IncludedGem/Illuminati-on/README.md

# Illuminati-on
HACK 2026 Team 13 Musical Instrument

Run serial.py then serial_bridge.py, open the site, then start the pico.
