IncludedGem/Illuminati-on/cad/fullKey.step

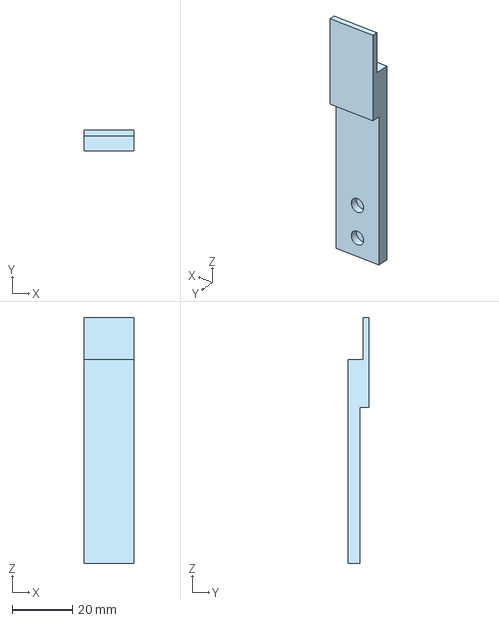
[picture p1: CAD file, 2026-08-09]
cad/fullKey.step
16.5 x 7.00 x 82.0 mm
