IncludedGem/Illuminati-on/cad/arrowButton.step

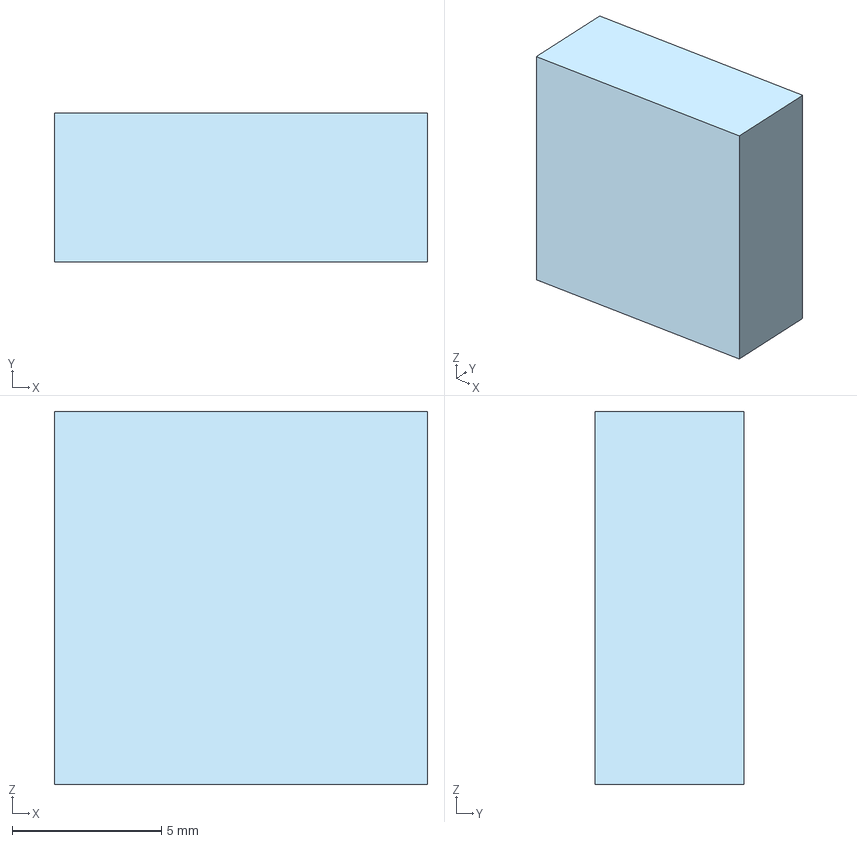
[picture p2: CAD file, 2026-08-11]
cad/arrowButton.step
12.5 x 5.00 x 12.5 mm
