IncludedGem/Illuminati-on/cad/playPauseButton.step

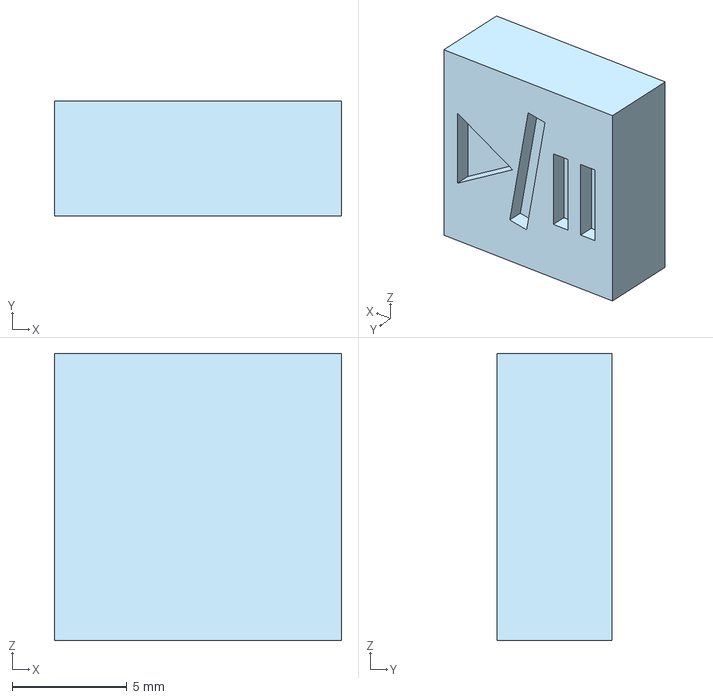
[picture p3: CAD file, 2026-08-11]
cad/playPauseButton.step
12.5 x 5.00 x 12.5 mm
