IncludedGem/Illuminati-on/cad/insideSupport.step

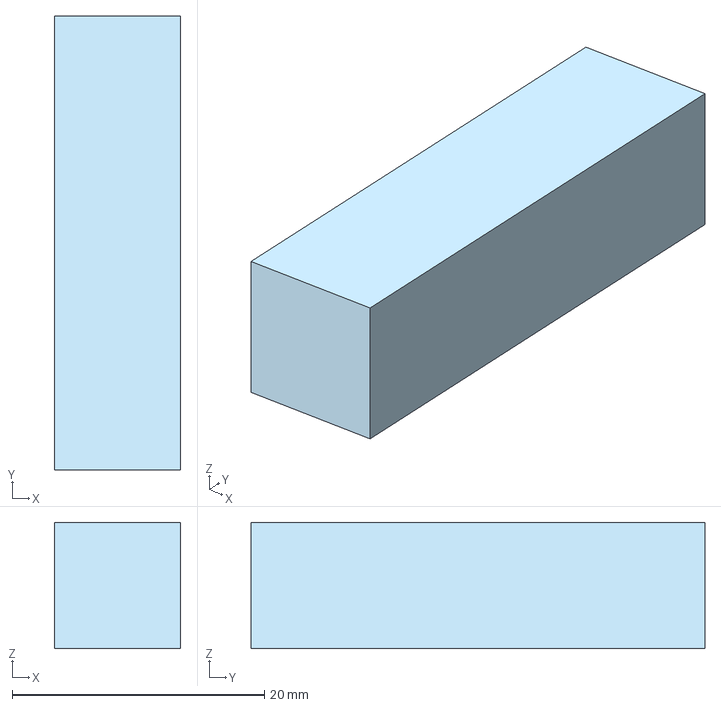
[picture p4: CAD file, 2026-08-11]
cad/insideSupport.step
10.0 x 36.0 x 10.0 mm
