IncludedGem/Illuminati-on/cad/pButton.step

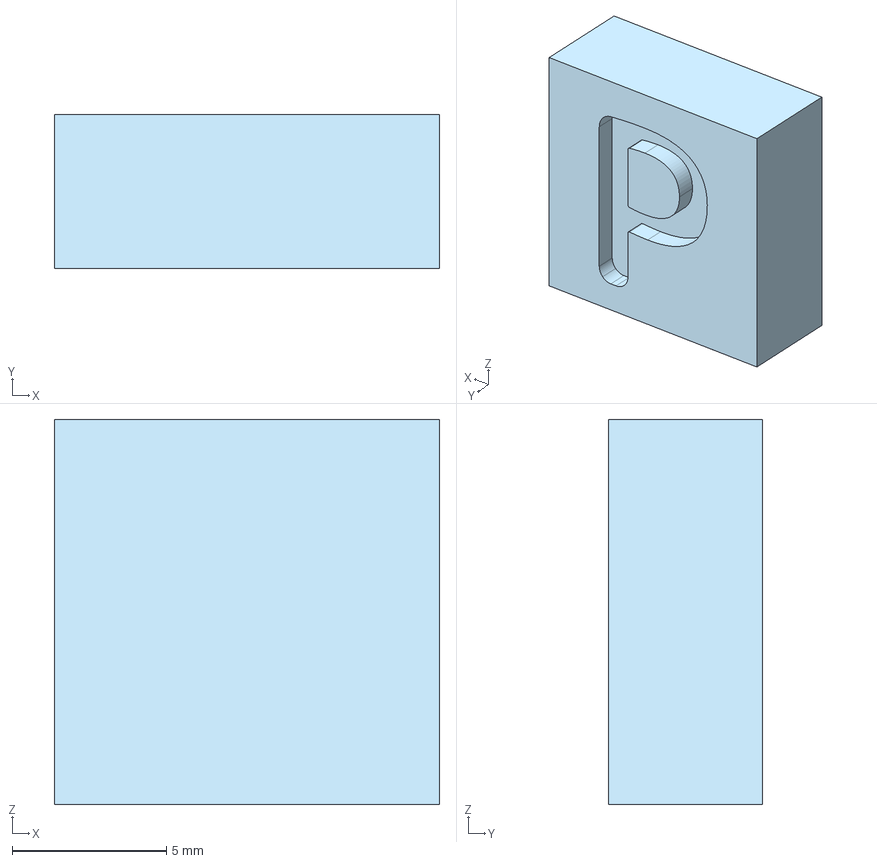
[picture p5: CAD file, 2026-08-11]
cad/pButton.step
12.5 x 5.00 x 12.5 mm
