IncludedGem/Illuminati-on/cad/recordButton.step

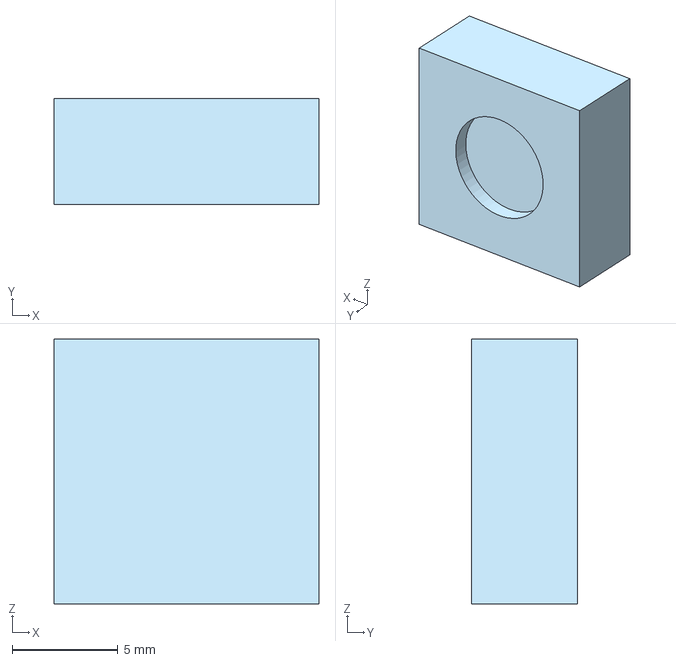
[picture p6: CAD file, 2026-08-11]
cad/recordButton.step
12.5 x 5.00 x 12.5 mm
