IncludedGem/Illuminati-on/cad/blackKey.step

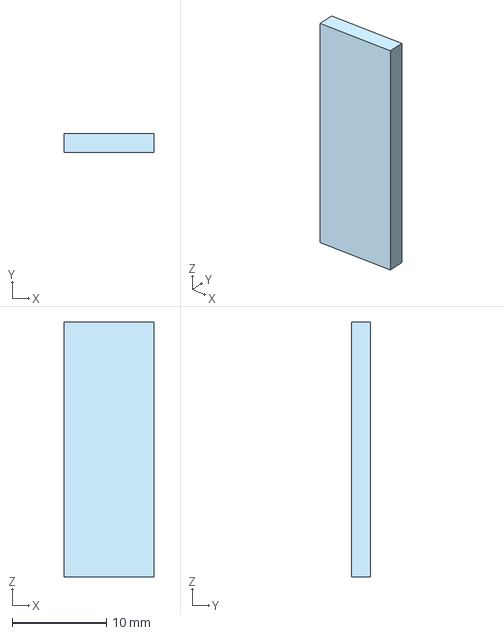
[picture p7: CAD file, 2026-08-11]
cad/blackKey.step
9.50 x 2.00 x 27.0 mm
