IncludedGem/Illuminati-on/cad/plate.dxf

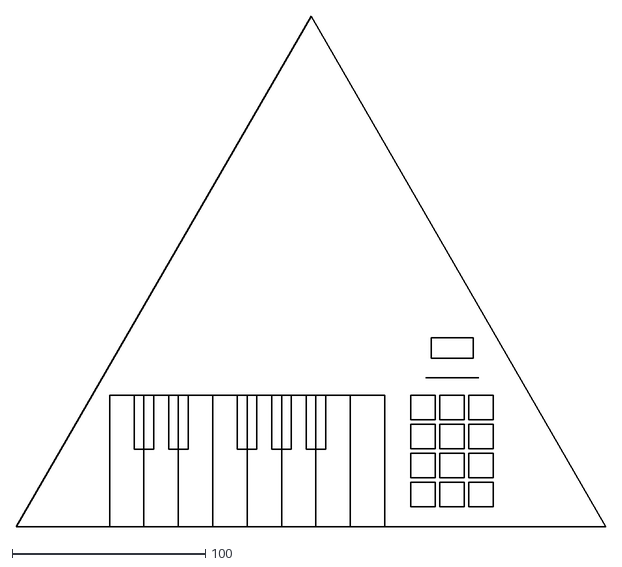
[picture p8: CAD file, 2026-08-09]
cad/plate.dxf
304.8 x 264.0
