IncludedGem/Illuminati-on/cad/2ND PLATE.dxf

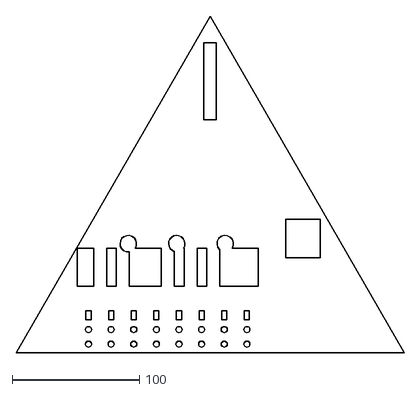
[picture p9: CAD file, 2026-08-09]
cad/2ND PLATE.dxf
304.8 x 264.0
