IncludedGem/Illuminati-on/cad/PLATE3.dxf

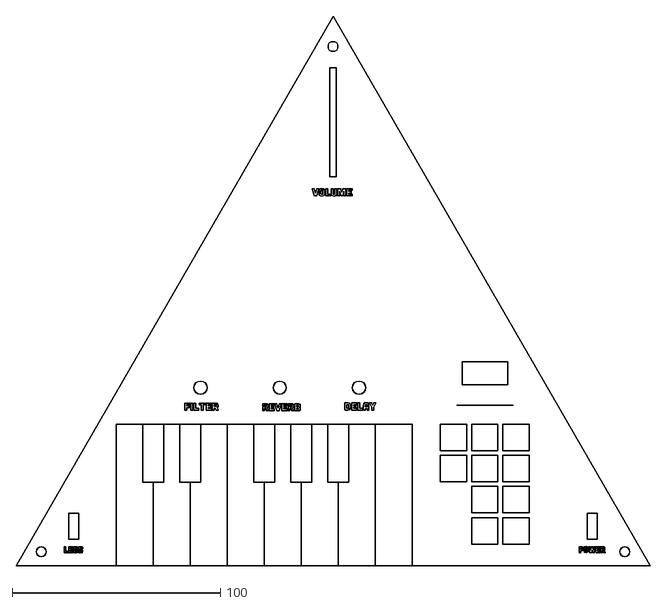
[picture p10: CAD file, 2026-08-09]
cad/PLATE3.dxf
304.8 x 264.0
