IncludedGem/Illuminati-on/cad/plate2.dxf

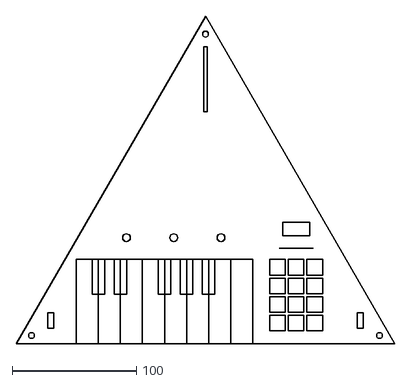
[picture p11: CAD file, 2026-08-09]
cad/plate2.dxf
304.8 x 264.0
