IncludedGem/Illuminati-on/cad/leftKey.step

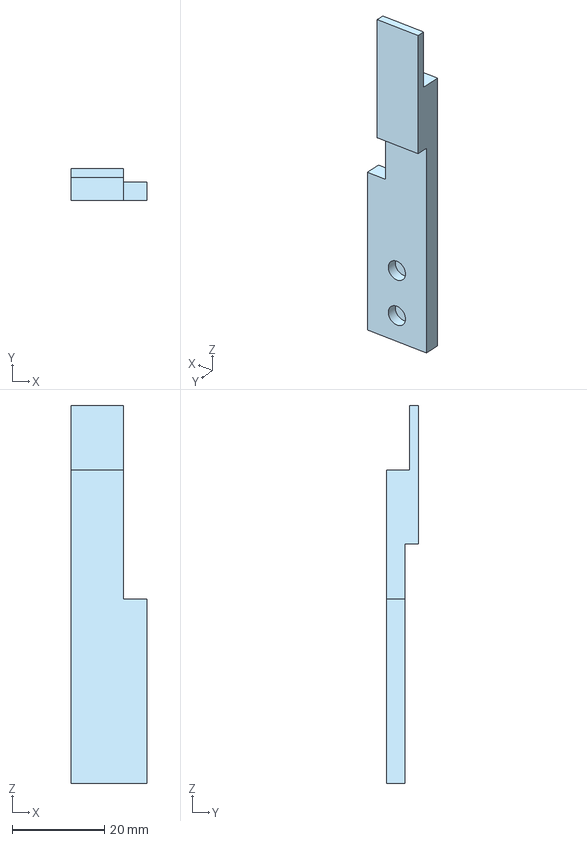
[picture p12: CAD file, 2026-08-09]
cad/leftKey.step
16.5 x 7.00 x 82.0 mm
