IncludedGem/Illuminati-on/cad/centerKey.step

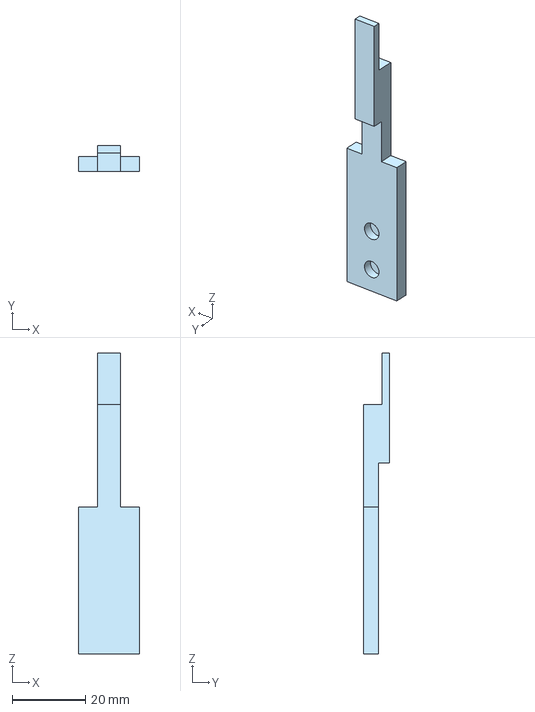
[picture p13: CAD file, 2026-08-09]
cad/centerKey.step
16.5 x 7.00 x 82.0 mm
