IncludedGem/Illuminati-on/cad/logo_triangle.dxf

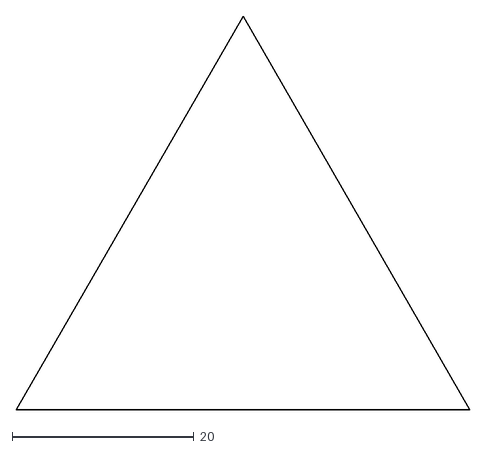
[picture p14: CAD file, 2026-08-09]
cad/logo_triangle.dxf
50.0 x 43.3
