IncludedGem/Illuminati-on/cad/cablePanel13.dxf

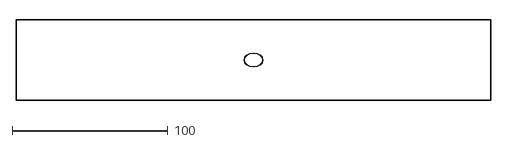
[picture p15: CAD file, 2026-08-09]
cad/cablePanel13.dxf
304.8 x 52.0
