IncludedGem/Illuminati-on/cad/speakerPanel13.dxf

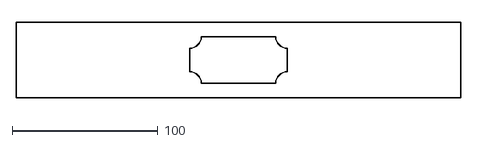
[picture p16: CAD file, 2026-08-09]
cad/speakerPanel13.dxf
304.8 x 52.0
