IncludedGem/Illuminati-on/cad/volumeHandle.step

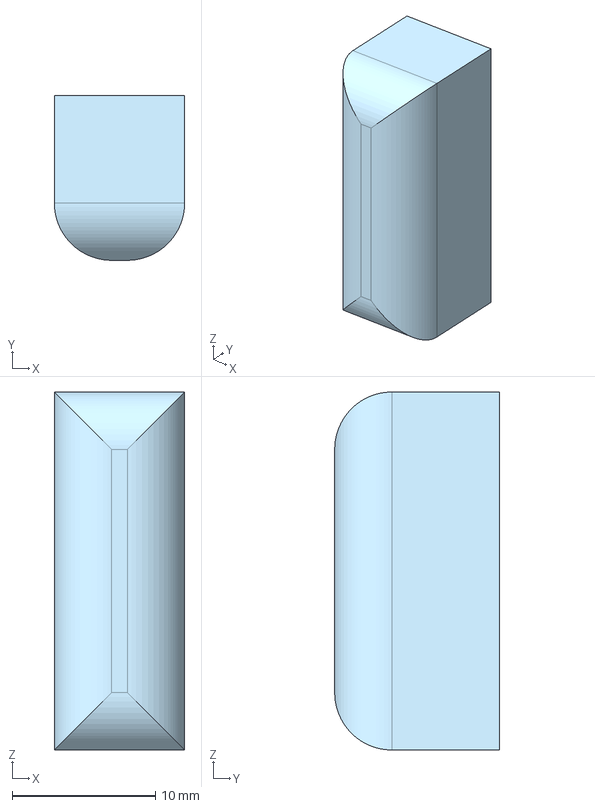
[picture p17: CAD file, 2026-08-09]
cad/volumeHandle.step
9.10 x 11.5 x 25.0 mm
