IncludedGem/Illuminati-on/(list of files, cad)

Other CAD files:
cad/mButton.step
cad/resetButton.step
cad/rightKey.step
