IncludedGem/Illuminati-on/Circuitry/illuminati-on Electronic Schematic - Final.pdf

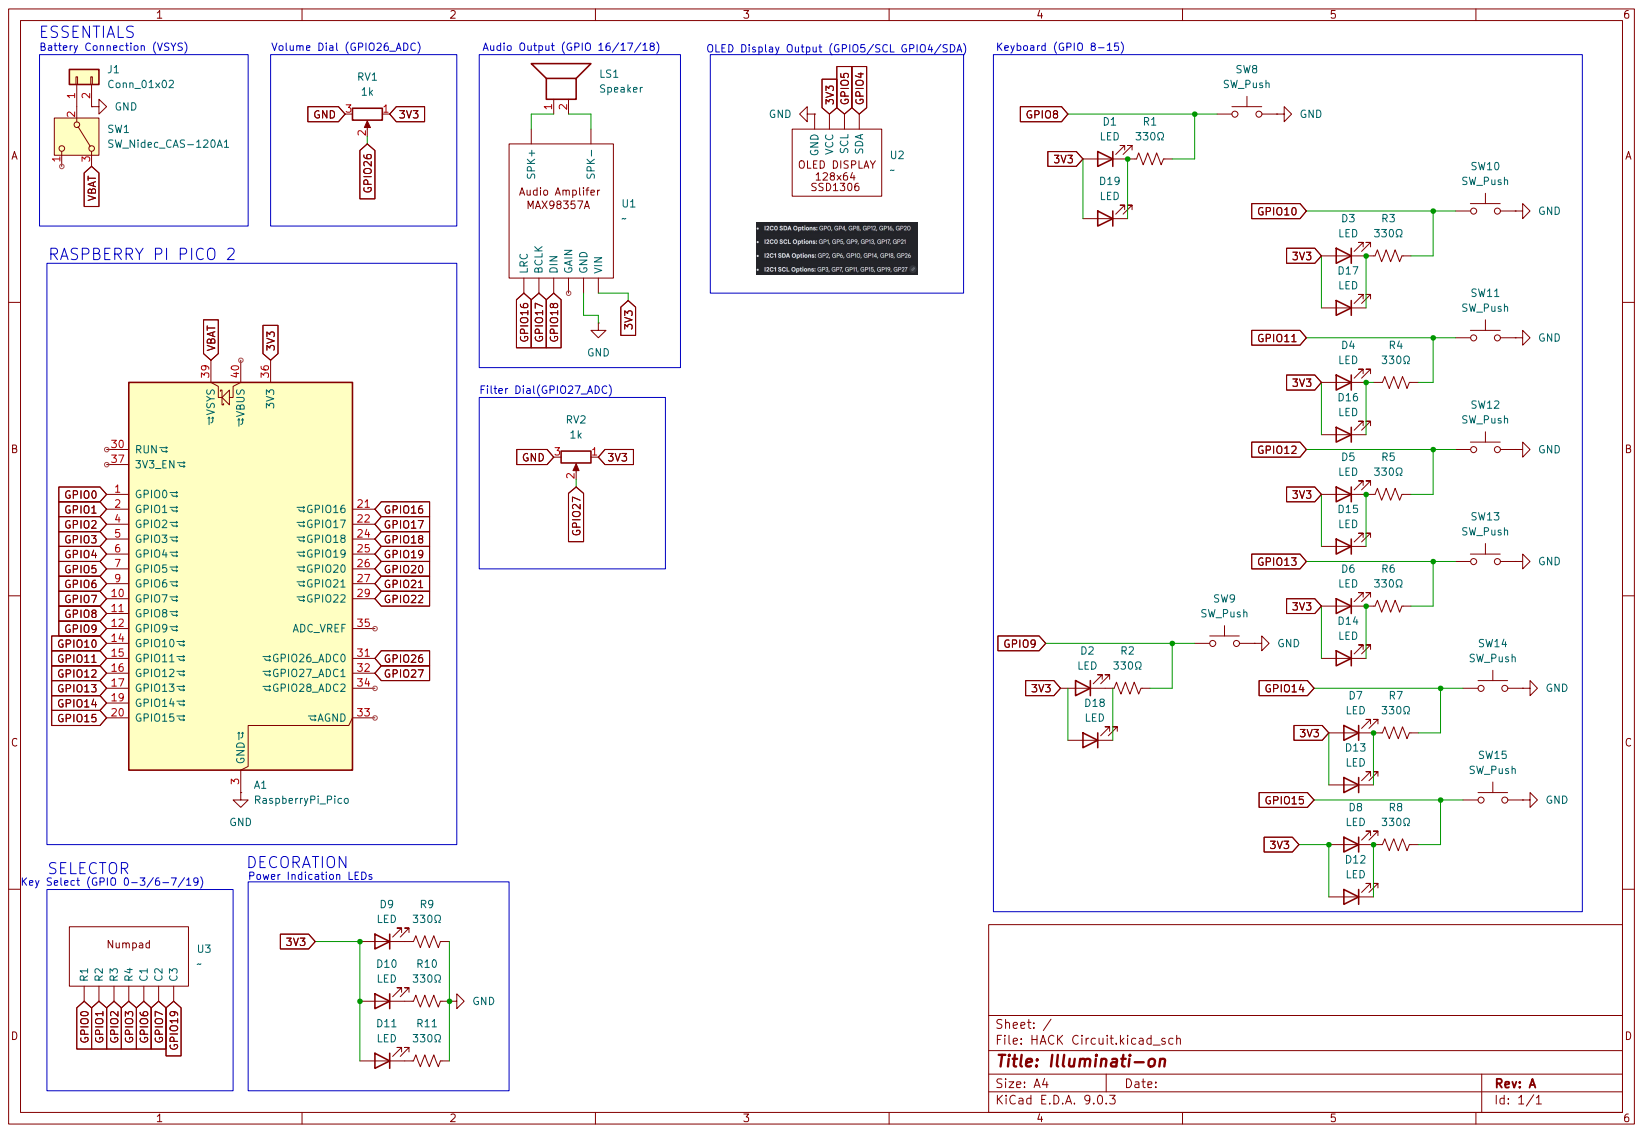
[picture p18: page 1]
