IncludedGem/Illuminati-on/Circuitry/illuminati-on Electronic Schematic - Plan.pdf

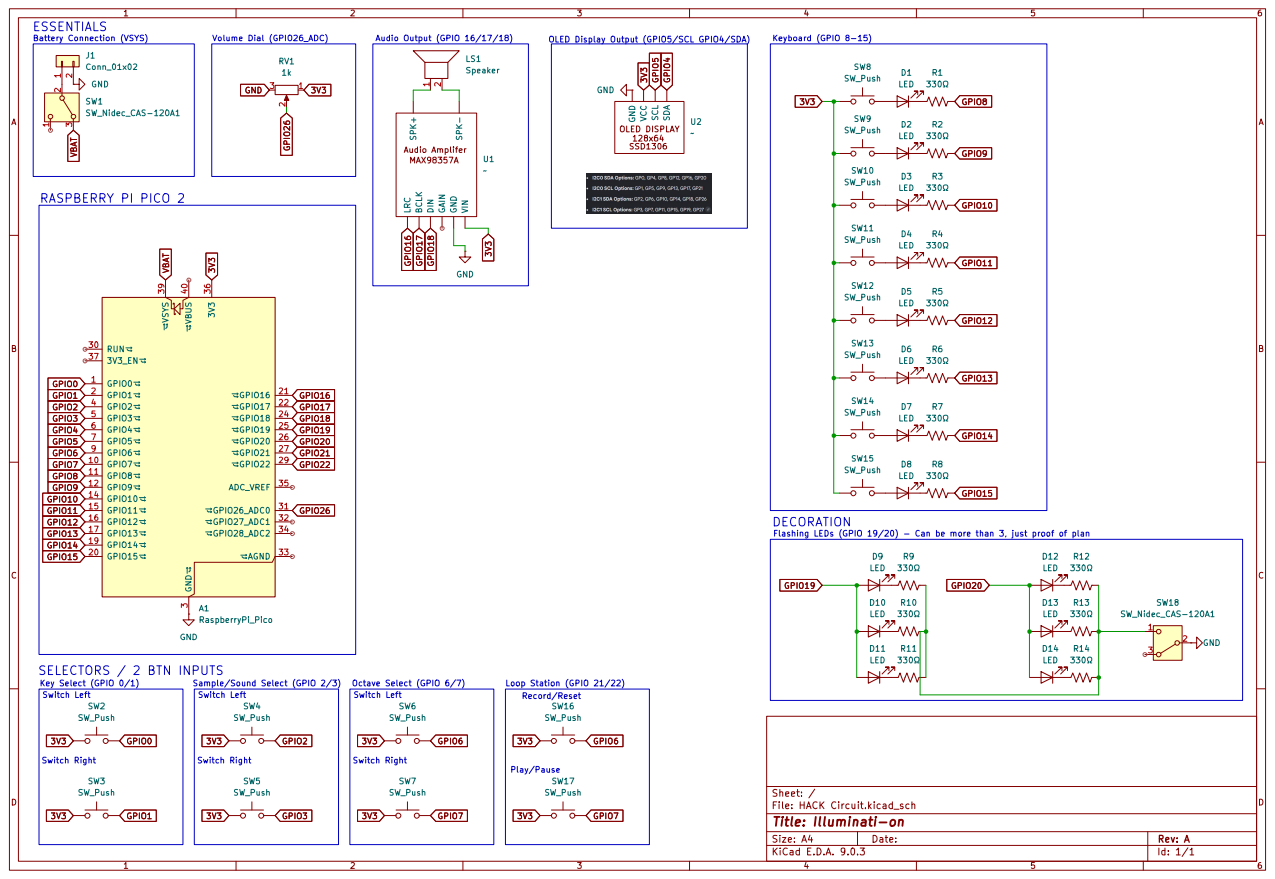
[picture p19: page 1]
