IncludedGem/Illuminati-on/Circuitry/HACK Circuit.kicad_sch

## KiCad design Circuitry/HACK Circuit.kicad_sch (2026-08-11, an earlier design)

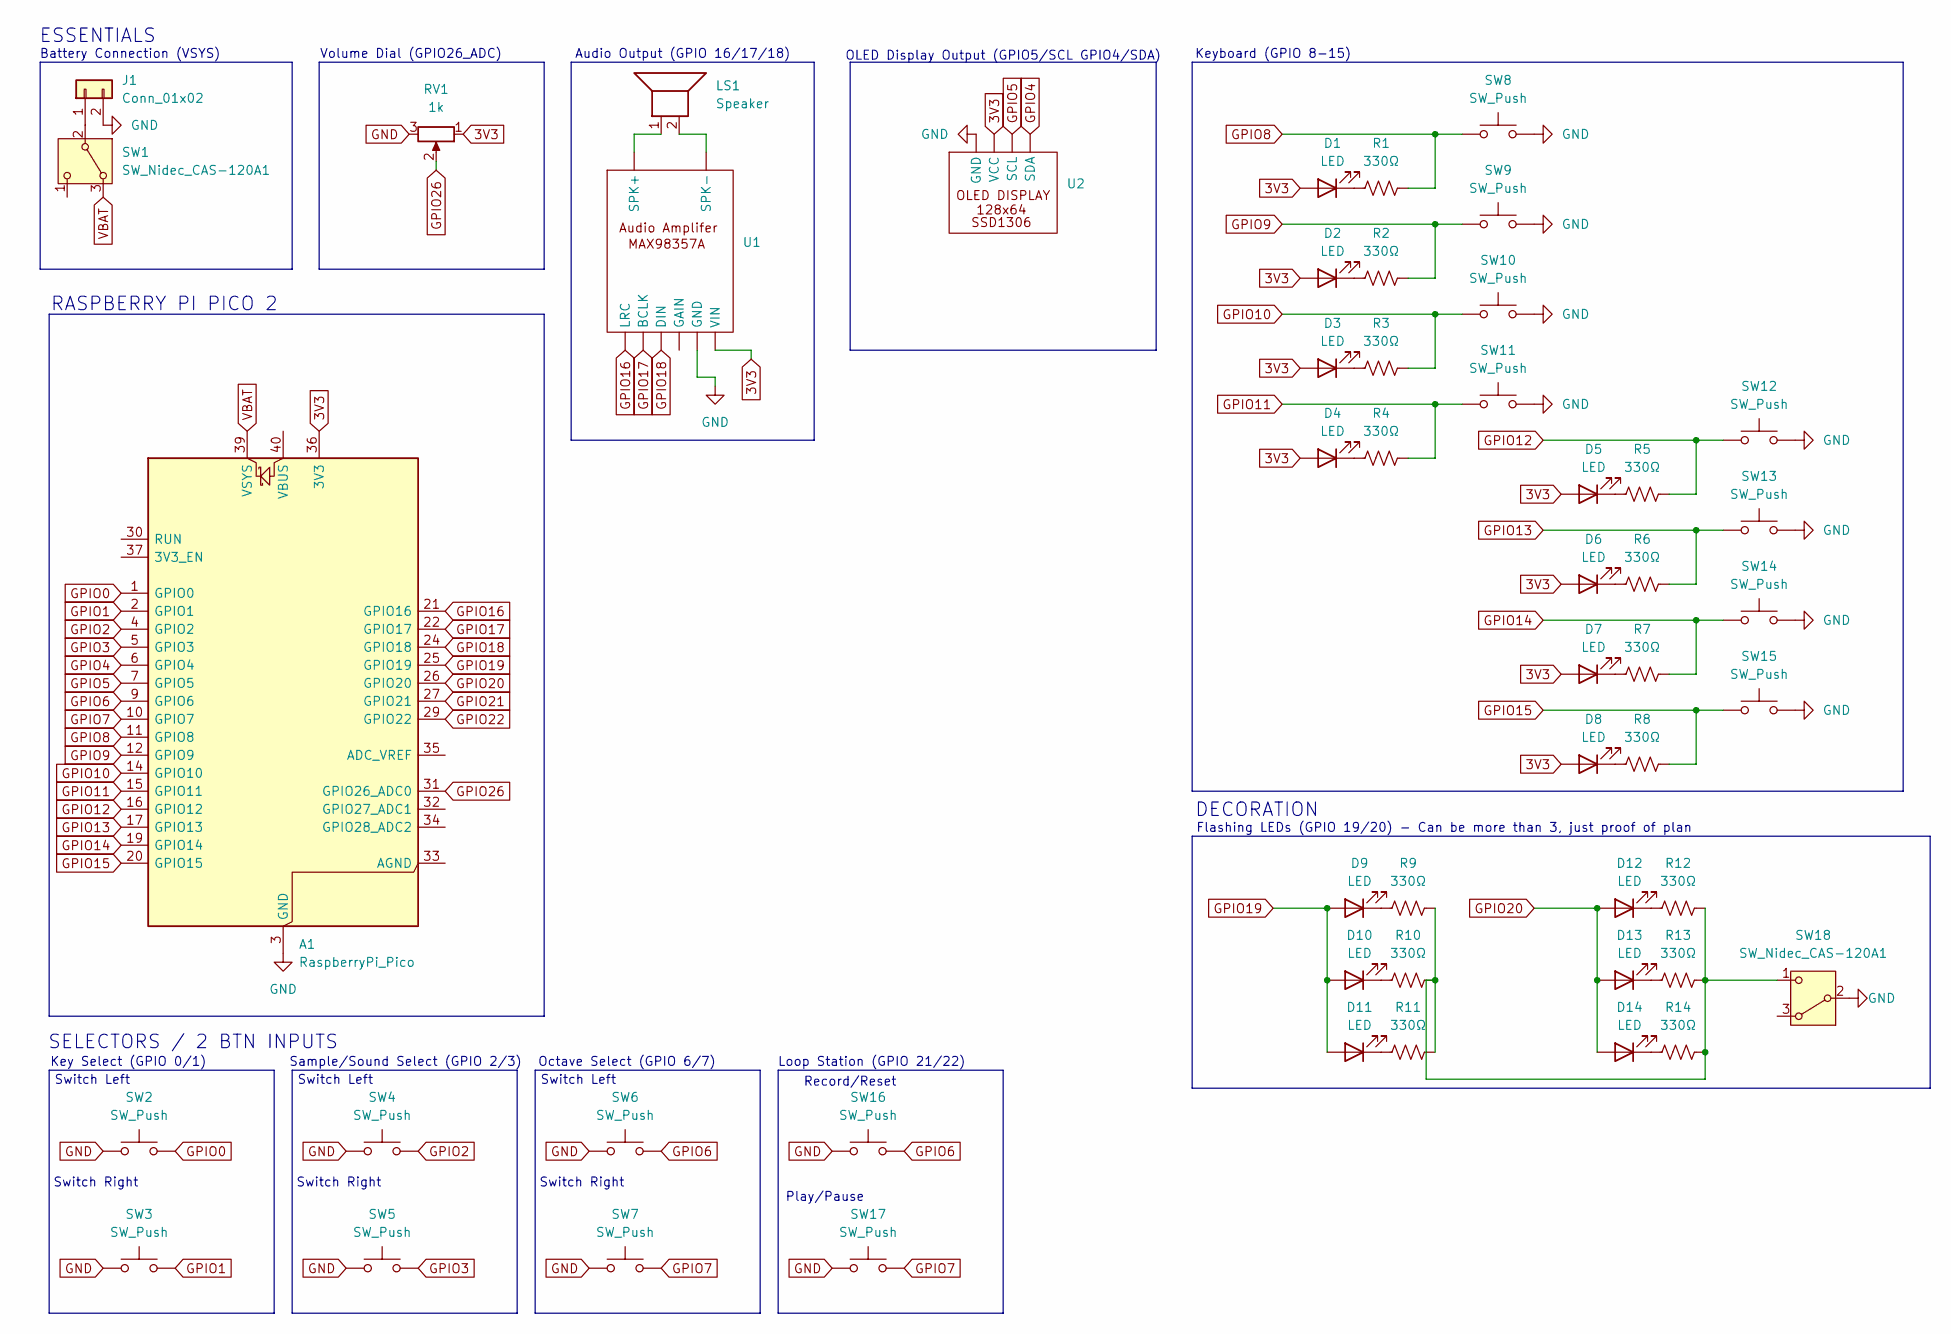
[picture p20: schematic HACK Circuit.kicad_sch]

Parts:
A1: RaspberryPi_Pico; RaspberryPi_Pico_Common_Unspecified
D1, D2, D3, D4, D5, D6, D7, D8, D9, D10, D11, D12, D13, D14: LED
J1: Conn_01x02; JST_GH_BM02B-GHS-TBT_1x02-1MP_P1.25mm_Vertical
LS1: Speaker
R1, R2, R3, R4, R5, R6, R7, R8, R9, R10, R11, R12, R13, R14: 330Ω
RV1: 1k
SW1, SW18: SW_Nidec_CAS-120A1; Nidec_Copal_CAS-120A
SW2, SW3, SW4, SW5, SW6, SW7, SW8, SW9, SW10, SW11, SW12, SW13, SW14, SW15, SW16, SW17: SW_Push
U1, U2: (no value)

Connections:
3V3: A1.36 (3V3), D1.2 (A), D2.2 (A), D3.2 (A), D4.2 (A), D5.2 (A), D6.2 (A), D7.2 (A), D8.2 (A), RV1.1, U1., U2.
GND: A1.3 (GND), A1.8 (GND), A1.13 (GND), A1.18 (GND), A1.23 (GND), A1.28 (GND), A1.38 (GND), J1.2, RV1.3, SW2.1, SW3.1, SW4.1, SW5.1, SW6.1, SW7.1, SW8.2, SW9.2, SW10.2, SW11.2, SW12.2, SW13.2, SW14.2, SW15.2, SW16.1, SW17.1, SW18.2 (B), U1., U2.
GPIO0: A1.1 (GPIO0), SW2.2
GPIO1: A1.2 (GPIO1), SW3.2
GPIO2: A1.4 (GPIO2), SW4.2
GPIO3: A1.5 (GPIO3), SW5.2
GPIO4: A1.6 (GPIO4), U2.
GPIO5: A1.7 (GPIO5), U2.
GPIO6: A1.9 (GPIO6), SW6.2, SW16.2
GPIO7: A1.10 (GPIO7), SW7.2, SW17.2
GPIO8: A1.11 (GPIO8), R1.2, SW8.1
GPIO9: A1.12 (GPIO9), R2.2, SW9.1
GPIO10: A1.14 (GPIO10), R3.2, SW10.1
GPIO11: A1.15 (GPIO11), R4.2, SW11.1
GPIO12: A1.16 (GPIO12), R5.2, SW12.1
GPIO13: A1.17 (GPIO13), R6.2, SW13.1
GPIO14: A1.19 (GPIO14), R7.2, SW14.1
GPIO15: A1.20 (GPIO15), R8.2, SW15.1
GPIO16: A1.21 (GPIO16), U1.
GPIO17: A1.22 (GPIO17), U1.
GPIO18: A1.24 (GPIO18), U1.
GPIO19: A1.25 (GPIO19), D9.2 (A), D10.2 (A), D11.2 (A)
GPIO20: A1.26 (GPIO20), D12.2 (A), D13.2 (A), D14.2 (A)
GPIO21: A1.27 (GPIO21)
GPIO22: A1.29 (GPIO22)
GPIO26: A1.31 (GPIO26_ADC0), RV1.2
unnamed: D1.1 (K), R1.1
unnamed: D2.1 (K), R2.1
unnamed: D3.1 (K), R3.1
unnamed: D4.1 (K), R4.1
unnamed: D5.1 (K), R5.1
unnamed: D6.1 (K), R6.1
unnamed: D7.1 (K), R7.1
unnamed: D8.1 (K), R8.1
unnamed: D9.1 (K), R9.1
unnamed: D10.1 (K), R10.1
unnamed: D11.1 (K), R11.1
unnamed: D12.1 (K), R12.1
unnamed: D13.1 (K), R13.1
unnamed: D14.1 (K), R14.1
unnamed: J1.1, SW1.2 (B)
unnamed: LS1.1, U1.
unnamed: LS1.2, U1.
unnamed: R9.2, R10.2, R11.2, R12.2, R13.2, R14.2, SW18.1 (C)
VBAT: A1.39 (VSYS), SW1.3 (A)

Notes on the sheet:
Play/Pause
Switch Right
Volume Dial (GPIO26_ADC)
Key Select (GPIO 0/1)
Switch Left
DECORATION
Record/Reset
ESSENTIALS
Audio Output (GPIO 16/17/18)
SELECTORS / 2 BTN INPUTS
Sample/Sound Select (GPIO 2/3)
Flashing LEDs (GPIO 19/20) - Can be more than 3, just proof of plan
Keyboard (GPIO 8-15)
Loop Station (GPIO 21/22)
Octave Select (GPIO 6/7)
Battery Connection (VSYS)
RASPBERRY PI PICO 2
OLED Display Output (GPIO5/SCL GPIO4/SDA)
