IncludedGem/Illuminati-on/(commit log)

2026-08-07 Initial Circuitry Design
    [HACK Circuit.kicad_pcb, HACK Circuit.kicad_sch]
2026-08-07 Add current numberpad test version
2026-08-07 Changed pin layout for numpad
2026-08-08 Adjusted numpad program to increment/decrement the current state.
2026-08-08 Added functions to keys 3 and 6 in order to cycle through sample type
2026-08-08 fixed numpad, deleted some less useful code, changed key state reference to numbers
    [numpad-test4.py]
2026-08-09 wow did a whole bunch of shit. added looper
    [2ND PLATE.dxf, PLATE3.dxf, plate.dxf, plate2.dxf]
2026-08-11 Schematic Final Update
    [HACK Circuit.kicad_sch]
2026-08-11 Fixed a few bugs within main.py
    [main.py]
